maneth-b03p/analog-guitar-effects-console/report/README.md

## Project Documentation

This folder contains all the final documentation for the Analog Guitar Effect Processing Console project:

- **Datasheet** - technical specifications
- **User Manual** - instructions for operating the device
- **Final Presentation**
- **Final Report**
