maneth-b03p/analog-guitar-effects-console/report/2_CYBERTRON_EN2091_Analog_Project.pdf

Department of Electronic & Telecommunication Engineering, University of Moratuwa, Sri Lanka.

# Analog Guitar Effects Processing Console

Group Members:

230018T | D.M.G.H. Adikaram
230074J | H.Y.W. Bandara
230476T | G.M.B. Perera
230486A | U.I.H. Perera

EN 2091 Laboratory Practice and Projects

06/12/2025

Analog Guitar Effect Processing Console | Group No 2

Abstract
This project presents the Analog Guitar Effects Processing Console, a compact device integrating four analog sub-circuits for guitar tone modification: Pre-Amplifier, Equalizer, Distortion, and Tremolo. The system utilizes modular architecture for reliability. Validation was conducted via LTSpice simulation and hardware testing. Hardware validation included FFT analysis to confirm the active equalizer’s effective boost/cut ranges and oscilloscope and digital multimeter readings for the rest of the circuit. The console successfully demonstrates a functional, portable, and versatile analog audio processing unit.

1

## Abbreviations and Acronyms

FFT Fast Fourier Transform

SR Slew Rate

DC Direct Current

AC Alternating Current

PCB Printed Circuit Board

LFO Low Frequency Oscillator

AWGN Additive White Gaussian Noise

2

## Contents

Abstract | 1
1 Introduction and Functionality | 4
2 System Architecture | 4
3 Component Selection | 5
4 PCB Design | 7
5 Enclosure Design | 9
6 Software Simulation and Hardware Testing | 10
7 Conclusion & Future Works | 13
8 Contribution of Group Members | 13
Acknowledgements | 14
Appendix | 14

3

## 1 Introduction and Functionality

This project aims to introduce a compact, custom audio console intended to for use with analog input devices, primarily the electric guitar. The output is designed to be fed directly into a separate power amplifier, allowing musicians to pre-set their entire core tone and effects chain in a single, portable device.
The console is engineered for live performance reliability and portability, requiring only initial setup and minor, on-the-demand adjustments.

This console consists of four main parts:

- Pre-Amplifier: For initial gain
- Equalizer: To amplify different frequency ranges (High, Mid, Treble)
- Tremolo: For Tremolo effect. The frequency and Depth can be controlled.
- Distortion: Distortion effect can be controlled

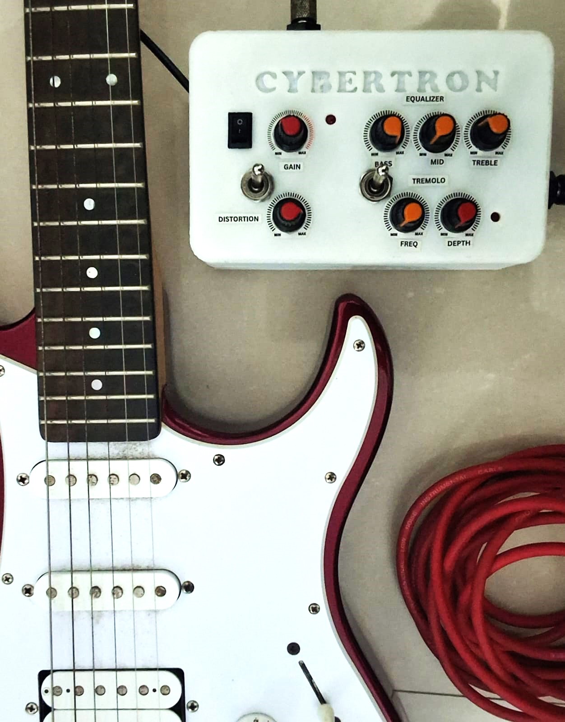
[picture p2: figure]

Figure 1: Analog Guitar Effects Unit

## 2 System Architecture

In this section, we’ll go through the circuitry system in an abstract manner. We’ll also mention the equations that help in identifying key parameters related to the product.

4

### 2.1 System-Level Abstraction of the Device

In Figure 2, we can see how the four systems are interconnected with input and output signals and how they are powered up and optionally bypassed.

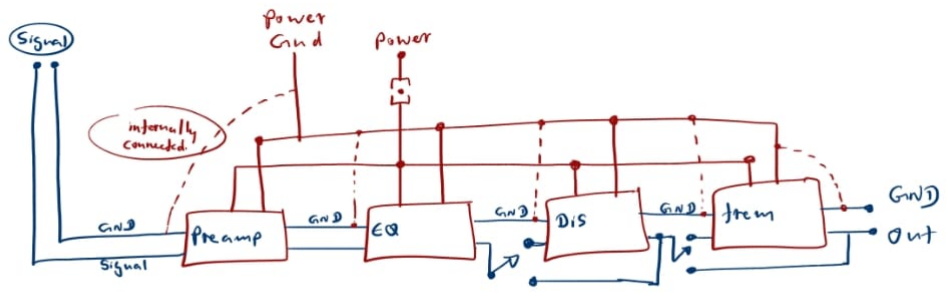
[picture p3: figure]

Figure 2: Flowgraph of the Circuitry

### 2.2 Equations

- Pre-Amplifier Voltage Gain (Av):

Av = 1 +

Rf
Ri
- Baxandall EQ Center Frequency for the mid-range control:

ωc =

1
RC
- Tremolo Timing (NE555 Astable Mode):

f =

1.44
(RA + 2RB)C

Duty Cycle(%) = RA + RB
RA + 2RB

× 100

### 2.3 Sub-Circuits

The device contains four separate sub-circuits–one for each effect– so that each module can be built, tested, and verified independently before integration. This simplifies debugging, as any failure or undesired behavior can be quickly isolated. Also, if any fault occurs during a live performance (eg: Tremolo Board), it can be quickly swapped out without having to replace or repair the entire console circuit.

## 3 Component Selection

In this section, we will illustrate some of the decisions we made in selecting components and the reasons behind them.

- TL071CP / TL082CP

Requirements:

– Power dissipation at idle: 0.4 mW – Op-amp bandwidth: 80 Hz to 3 kHz

5

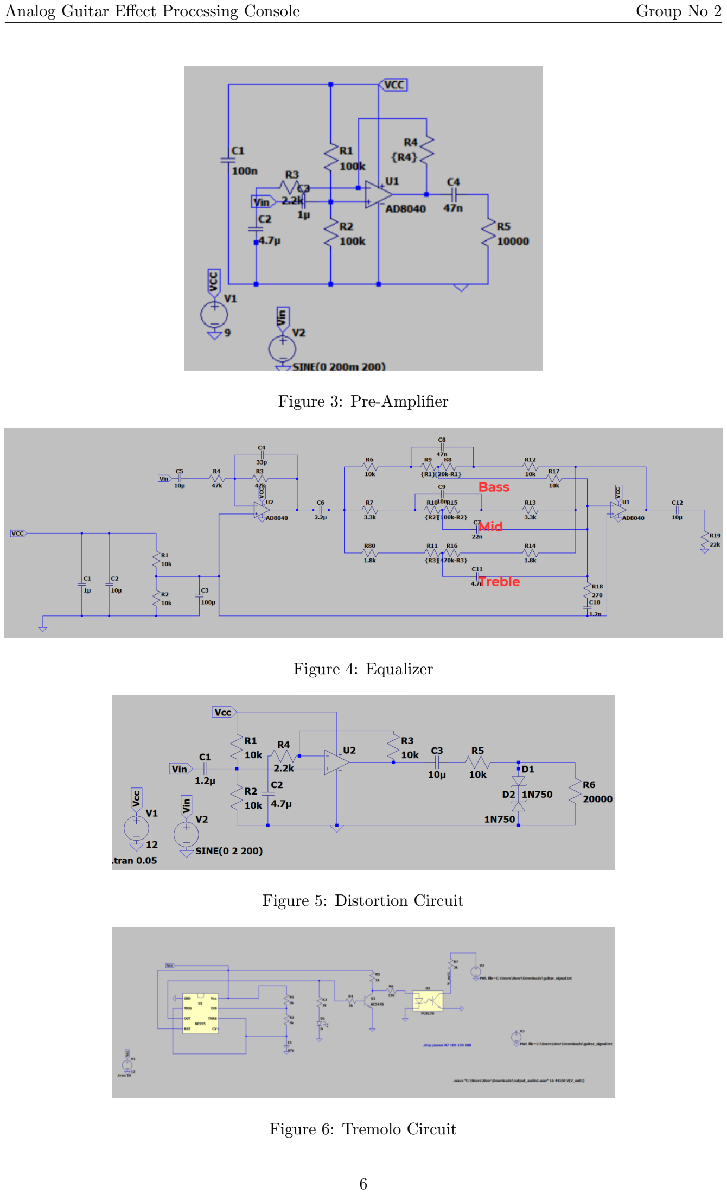
[picture p4: page 7]

Figure 3: Pre-Amplifier

Figure 4: Equalizer

Figure 5: Distortion Circuit

Figure 6: Tremolo Circuit

6

– Input amplitude:
∗ Average: 100–200 mV
∗ Maximum: 500 mV

– Expected output amplitude: 1–2 V

– Required gain-bandwidth product: 0.064 MHz
– Required slew rate (SR): 226.1 V/ms

We used popular low-noise operational amplifiers TL082CP (Dual Op-amp) and TL072CP (Single Op-amp) since they satisfy all the requirements. For the circuits that require two op-amps, such as the Equalizer, we used the dual op-amp to reduce component count.

- NE555 Timer

We used this hybrid component because of its simplicity, reliability, and stability in providing an accurate timing for tremolo effect, which is essential in live performances. For this particular application, we used Astable mode.

- Zener Diode Selection

We observed that the output of the equalizer is around 2V − 3V . To have a good distortion effect, it should be able to produce a higher gain (for consistency in volume) to be clipped. So we used 3.3V zener diodes so that the signal can be clipped around 4V , necessitating the requirement.

- Resistors and Capacitors

Based on circuit simulations and mathematical Equations provided in Section 2.2.

## 4 PCB Design

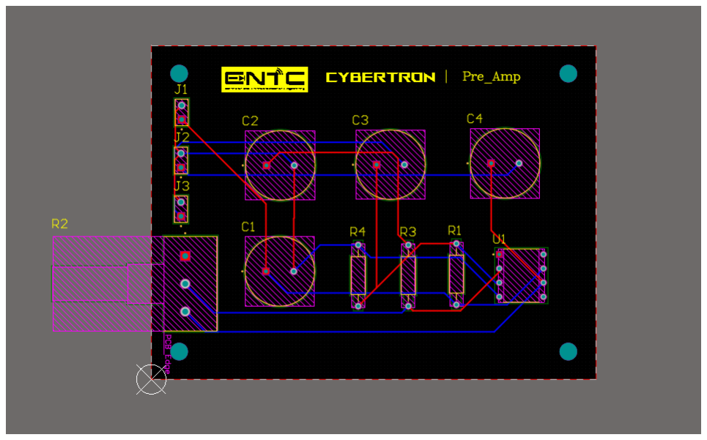
[picture p5: figure]

Figure 7: Pre-Amplifier

7

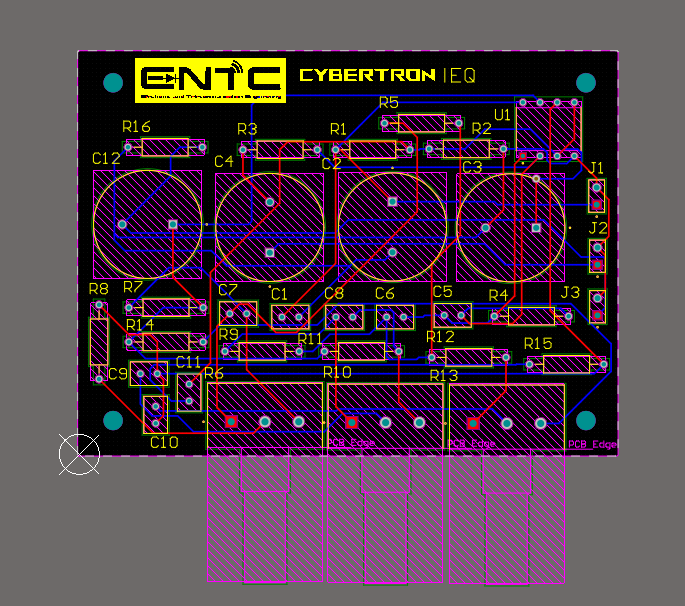
[picture p6: figure]

Figure 8: Equalizer

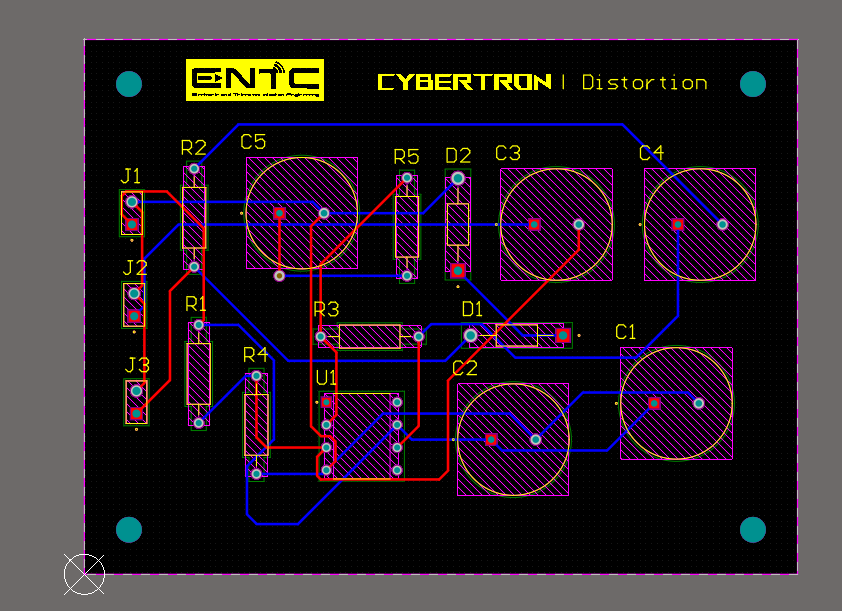
[picture p7: figure]

Figure 9: Distortion

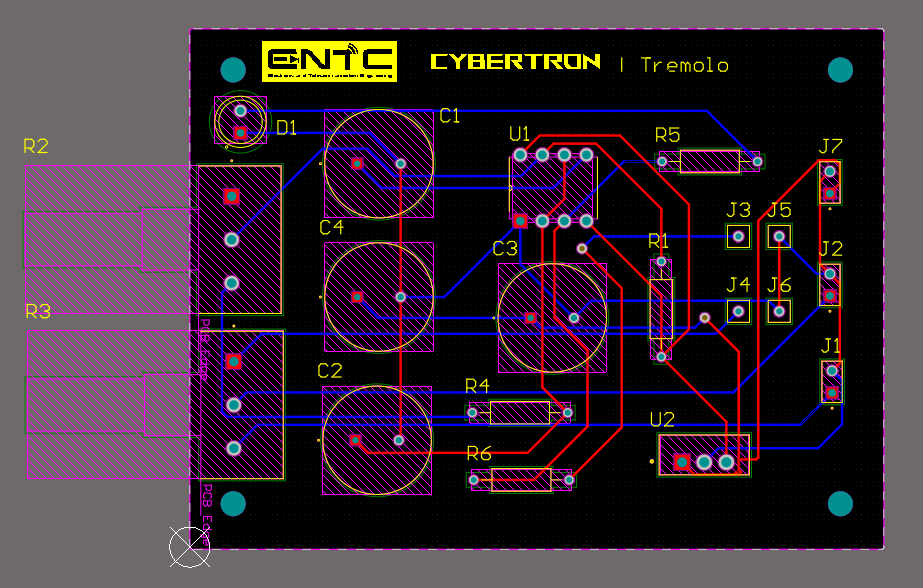
[picture p8: figure]

Figure 10: Tremolo

All the PCB designs are 80 mm × 60 mm in dimensions and consist of two layers. Designs are done using Altium Designer software.

8

## 5 Enclosure Design

Physical Specifications

- Enclosure Dimensions (L × W × H): 160 mm × 100 mm × 53 mm
- Overall Weight: 200 g
- Fabrication Material: PLA (Polylactic Acid)

SOLIDWORKS Designs

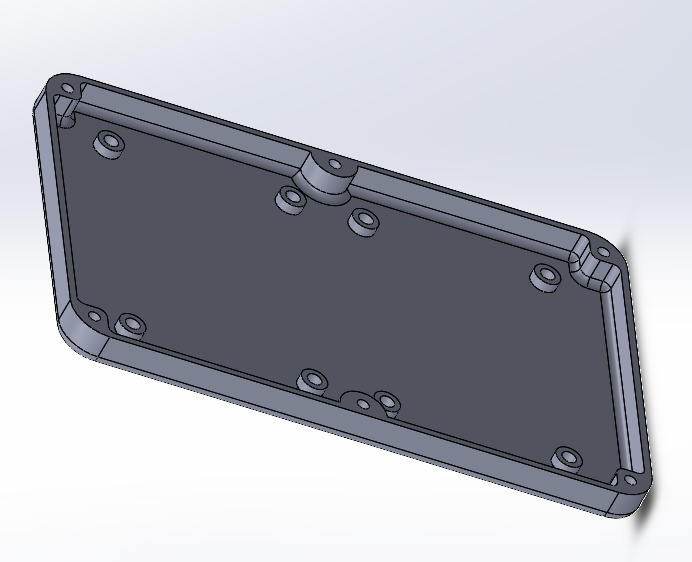
[picture p9: figure]

Figure 11: Bottom Lid

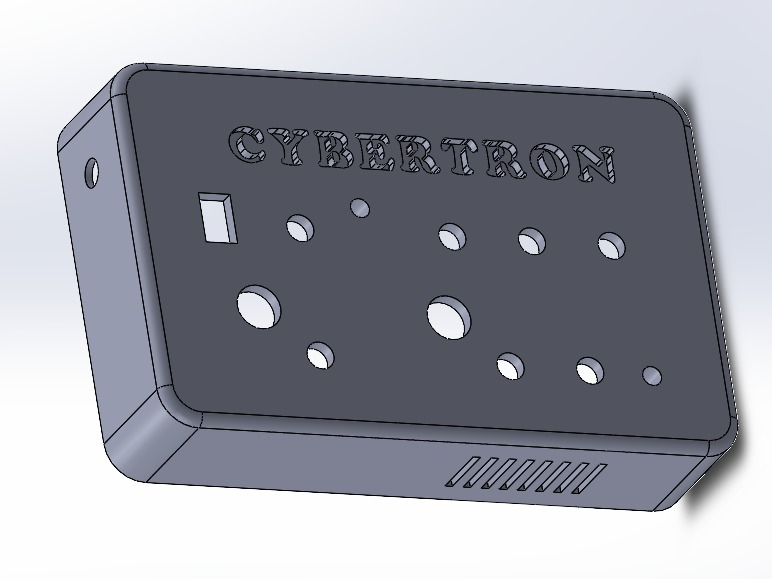
[picture p10: figure]

Figure 12: Top Lid

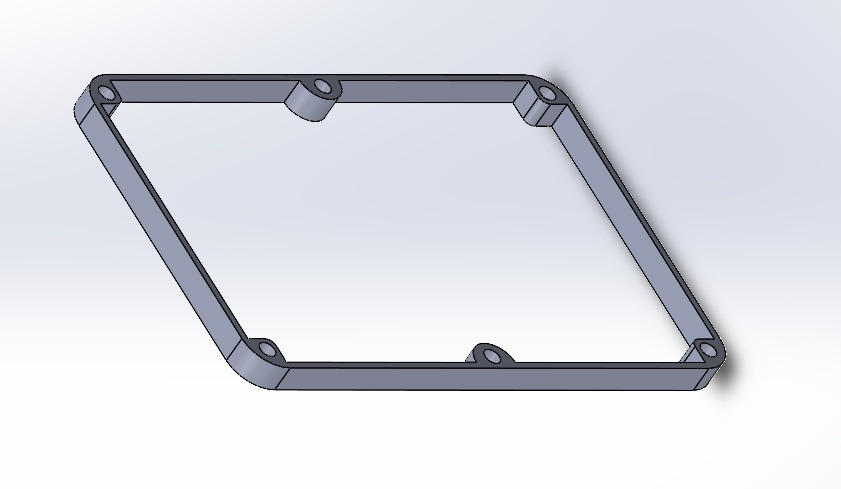
[picture p11: figure]

Figure 13: Inter-Layer

9

## 6 Software Simulation and Hardware Testing

This section details the verification of the console’s functional blocks through circuit simulation (LTSpice) and the validation of key performance metrics using hardware testing and analysis (Fast Fourier Transform, FFT).

### 6.1 Simulation Results (LTSpice)

Each module’s design was simulated to ensure expected electrical behavior, gain structure, frequency response, and transient stability before fabrication.

### 6.1.1 Pre-Amplifier Simulation

- Goal: Verify whether the required gain is achieved with minimal phase offset.
- Result: The simulation confirmed a maximum non-inverting gain of 20 dB with negligible DC offset, correctly driving the signal to the Equalizer stage.

Figure 14:

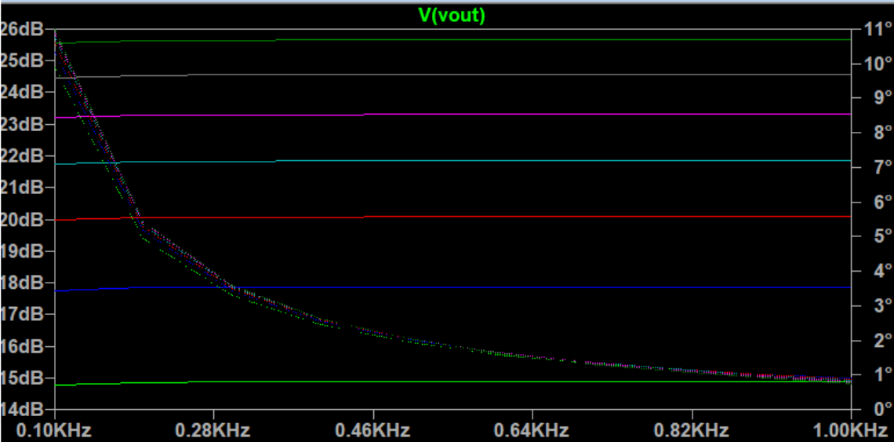
[picture p12: figure]

1) — Gain Stability of pre-amp across a range of frequencies, for different values of potentiometer (0 Ω - 20 Ω )
2) - - Phase offset for different potentiometer values. Observation: Negligible phase offsets.

### 6.1.2 Equalizer Simulation

- Goal: Verify the center frequencies and the maximum boost/cut range of the three-band active filter.
- Result: Output voltage for 2V input from preamp shows that the required gain and cutoff frequencies have been achieved.

10

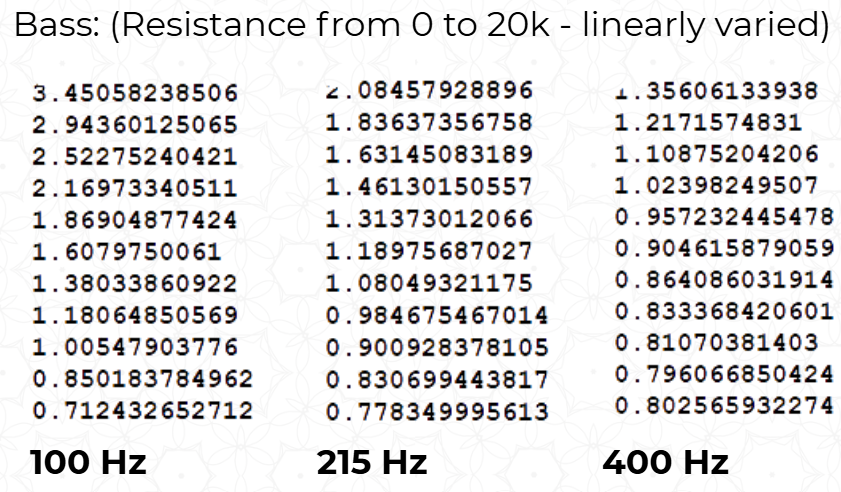
[picture p13: figure]

Figure 15: Gain variation for Bass across low frequencies

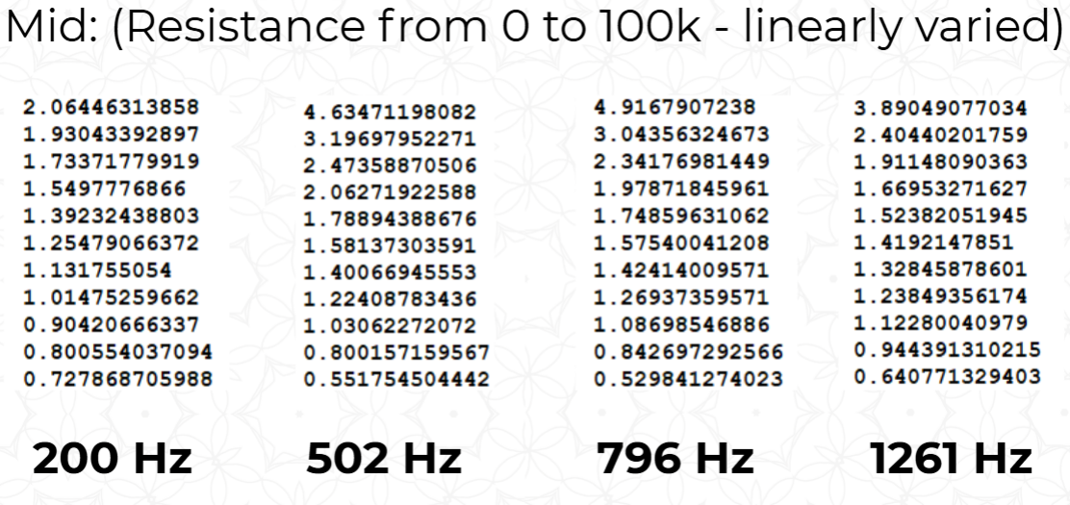
[picture p14: figure]

Figure 16: Gain variation for Mid across midband frequencies

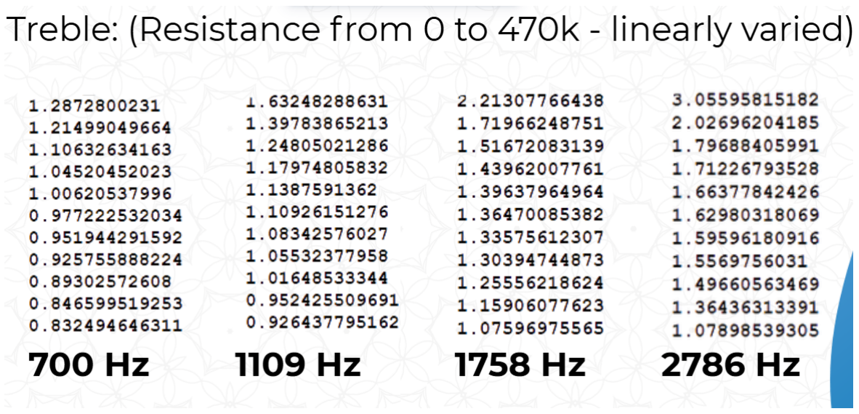
[picture p15: figure]

Figure 17: Gain variation for treble across high frequencies

### 6.1.3 Distortion Simulation

- Goal: Verify the clipping action of the back-to-back diode arrangement and distortion effect.
- Result: The transient analysis confirmed symmetrical clipping at approximately ±4 V (Zener breakdown voltage + forward bias voltage).

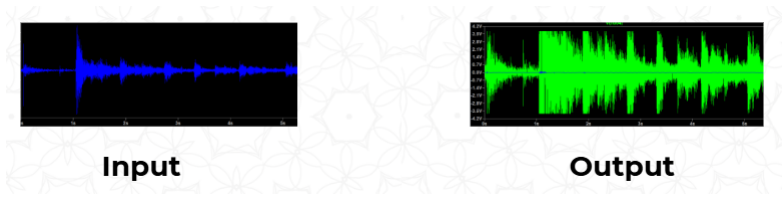
[picture p16: figure]

Figure 18: Distortion Effect: Voltage variation with respect to time

11

### 6.1.4 Tremolo Simulation

- Goal: Verify the Low Frequency Oscillator (LFO) frequency range and the modulation depth control.
- Result: The NE555 LFO circuit achieved a frequency range from 0.5 Hz to 6.5 Hz. The VCA/Opto-coupler simulation confirmed the ability to modulate the audio signal amplitude from 0% to 90% depth.

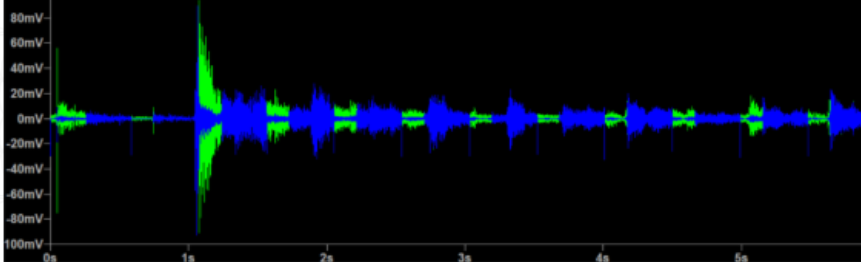
[picture p17: figure]

Figure 19: Tremolo Effect Simulation: Green - Input Signal, Blue - Output Signal

### 6.2 Hardware Testing and Validation

The physical prototype was subjected to key measurements to validate the core audio performance against specifications.

### 6.2.1 FFT Analysis for Equalizer Performance

- Test: To have a thorough understanding of frequency response, ideally, one should produce an impulse response, which isn’t practical. So what the test does is provide an AWGN signal and a normal guitar strum separately and observe the FFT through an oscilloscope.
- Goal: Confirm the filter’s response for the given frequency ranges.
- Result:

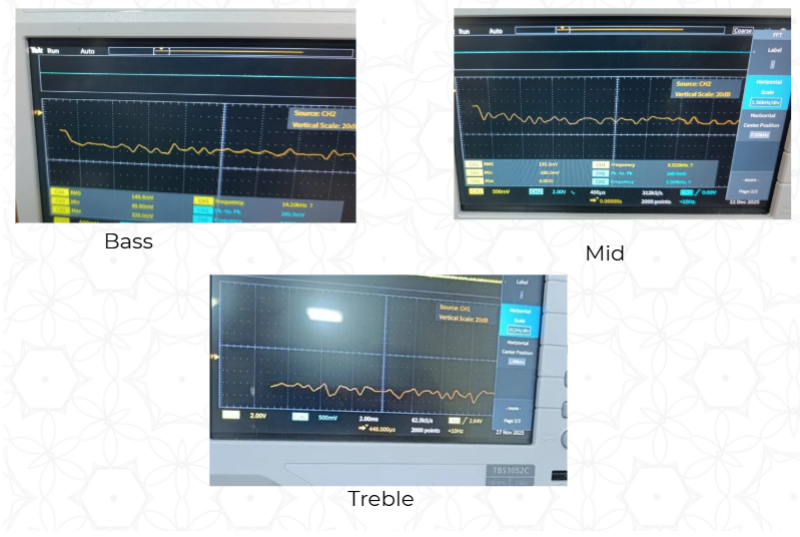
[picture p18: figure]

Figure 20: FFT plot validating the boost of magnitude and filtering of different frequency bands.

12

Explanation: Guitars naturally produce high power for low frequencies (due to higher vibrations). In addition, in the oscilloscope, it isn’t easy to distinguish base frequencies and mid frequencies due to the minimum sensitivity being 1.5 kHz/div. But the treble effect demonstrates a significant observation by attenuating lower frequencies, effectively highlighting the high frequencies of the audio.

## 7 Conclusion & Future Works

The Analog Guitar Effects Processing Console was successfully designed and validated, realizing a compact device that integrates four essential analog effects: Pre-Amplifier, Equalizer, Distortion, and Tremolo. The system’s modular, low-noise architecture was confirmed through simulation and hardware testing to meet all performance specifications, delivering a versatile and reliable multi-effect processing unit.
Future enhancements should focus on expanding the console’s versatility. The modular design allows for the straightforward integration of new effects, notably the addition of a Wah Filter and a Vibrato Effect module.

## 8 Contribution of Group Members

Table 1: Individual Group Member Contributions
Member Name / Index | Contributions
230018T D.M.G.H. Adikaram | PCB Design, Component Selection, Assembling, Soldering
230074J H.Y.W. Bandara | Circuit Testing, PCB Design, Soldering, Assembling
230476T G.M.B. Perera | Simulation Testing, Enclosure Design, Circuit Selection, Re-
| port Documentation
230486A U.I.H. Perera | Simulation Testing, Circuit Testing, Datasheet and User
| Manual Documentation

13

## Acknowledgements

The successful completion of this project was made possible by the support of the following individuals and institutions.

Our deepest gratitude is extended to Dr. Sampath Perera (Lecturer/Supervisor) for essential guidance, insightful feedback.

Thanks are also due to Mr. Avishka Edirisinghe (Group Mentor) for dedicated support and guidance during project organization and execution.

The technical staff at the Digital Laboratory of Electronic and Telecommunication Department provided necessary access to equipment and components for circuit simulation and analysis

Finally, thanks to our friends, family, and colleagues for their encouragement and support throughout this project.

## References

[1] Circuit Digest. | Audio Equalizer / Tone Control Circuit with Bass, Treble and
Mid | Frequency | Control. | https://circuitdigest.com/electronic-circuits/
audio-equalizer-tone-control-circuit-with-bass-treble-and-mid-frequency-control, .
[2] Curious Motor. Simple 555 based Tremolo Effect. https://curiousmotor.com/2020/06/04/simple-555-based-tremolo-effect/, 2020. .

## Appendix

A. Component Bill of Materials (BOM) and Estimated Cost

A list of specific components required to construct the final product, with the prices in LKR.
Component | Count | Value/Type | Unit Price | Total
IC1 | 1 | 555 Timer (NE555) | 30 | 30
IC2 | 2 | TL071CP | 50 | 100
IC3 | 1 | TL082CP | 20 | 20
Resistor | 30 | 10kΩ, 100kΩ, 22kΩ, etc. | 5 | 150
Capacitor | 20 | 1µF, 10µF, etc. | 20 | 400
Potentiometer | 7 | 100kΩ | 40 | 280
LED | 3 | Standard Red LED | 10 | 30
LDR | 1 | 4mm LDR (30kΩ − 3MΩ | 20 | 20
PCB | 4 | - | 200 | 800
AC-DC converter | 1 | 230V AC to 12V DC Transformer | 850 | 850
Enclosure | - | Manufactured using PLA | - | 2000
Additional Expenses
(Wires, Shipping,
Ports, knobs etc.) | - | - | - | 6000
Estimated Total Manufacturing Cost (LKR): | 10680
B. Mathematical Derivation of LFO Frequency

The frequency of oscillation (f) for the 555 Timer in its astable configuration, commonly used for the Tremolo LFO, is determined by the timing resistors (RA, RB) and the timing capacitor (C).

| | 14

The frequency is calculated using the following equation:

f =

1.44
(Ra + 2Rb)C

Ra = 50 kΩ

Rb = 0–500 kΩ (variable resistor)

C = 47 µF

fmin = 0.549 Hz

fmax = 6.417 Hz

In a practical tremolo circuit, one of the resistors (typically RB) is made variable (a potentiometer) to allow the user to adjust the modulation rate. For slow modulation, CT must be large (e.g., 1µF or larger).

15
