maneth-b03p/analog-guitar-effects-console/report/Presentation.pdf

# ANALOG GUITAR

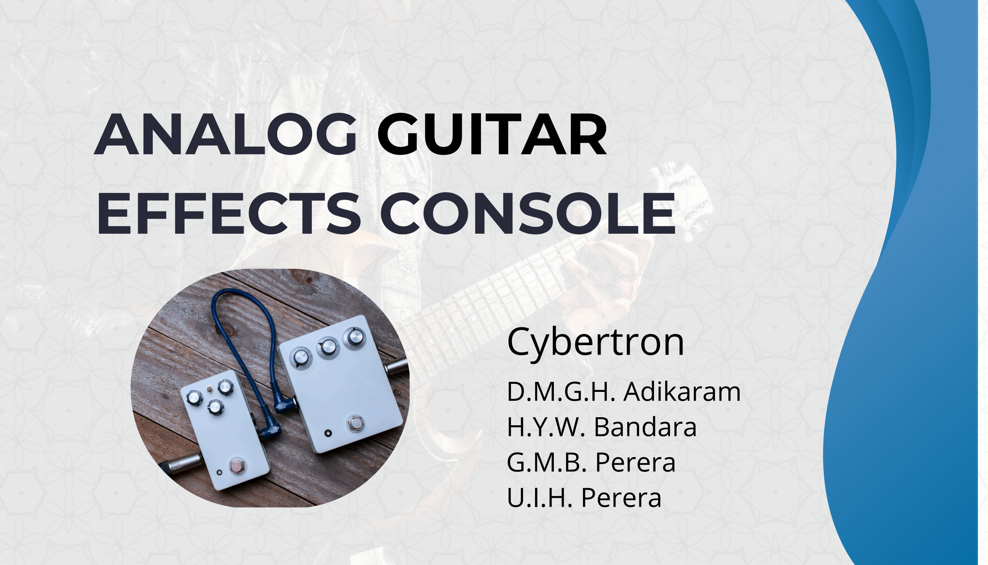
[picture p19: page 1]

# EFFECTS CONSOLE

### Cybertron D.M.G.H. Adikaram

### H.Y.W. Bandara G.M.B. Perera U.I.H. Perera

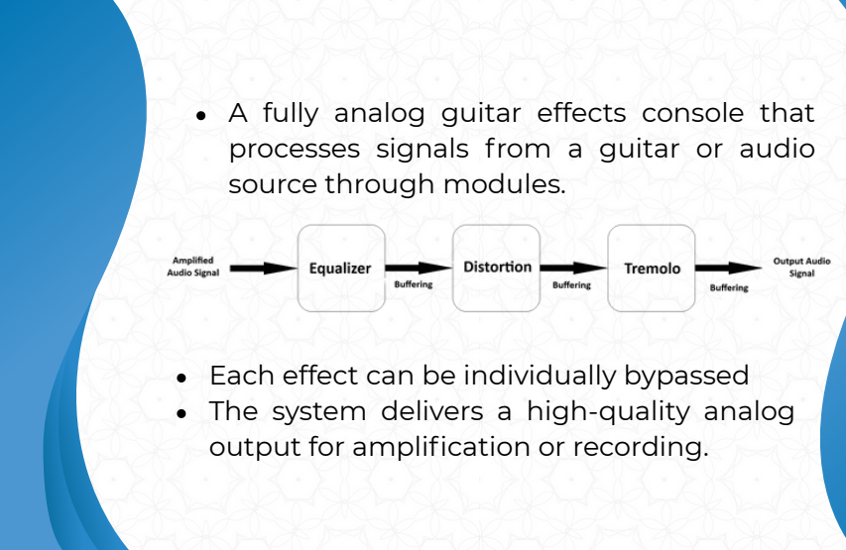
[picture p20: figure]
source through modules.; output for amplification or recording.

A fully analog guitar effects console that processes signals from a guitar or audio

Each effect can be individually bypassed The system delivers a high-quality analog

# Outcome of each sub-circuit

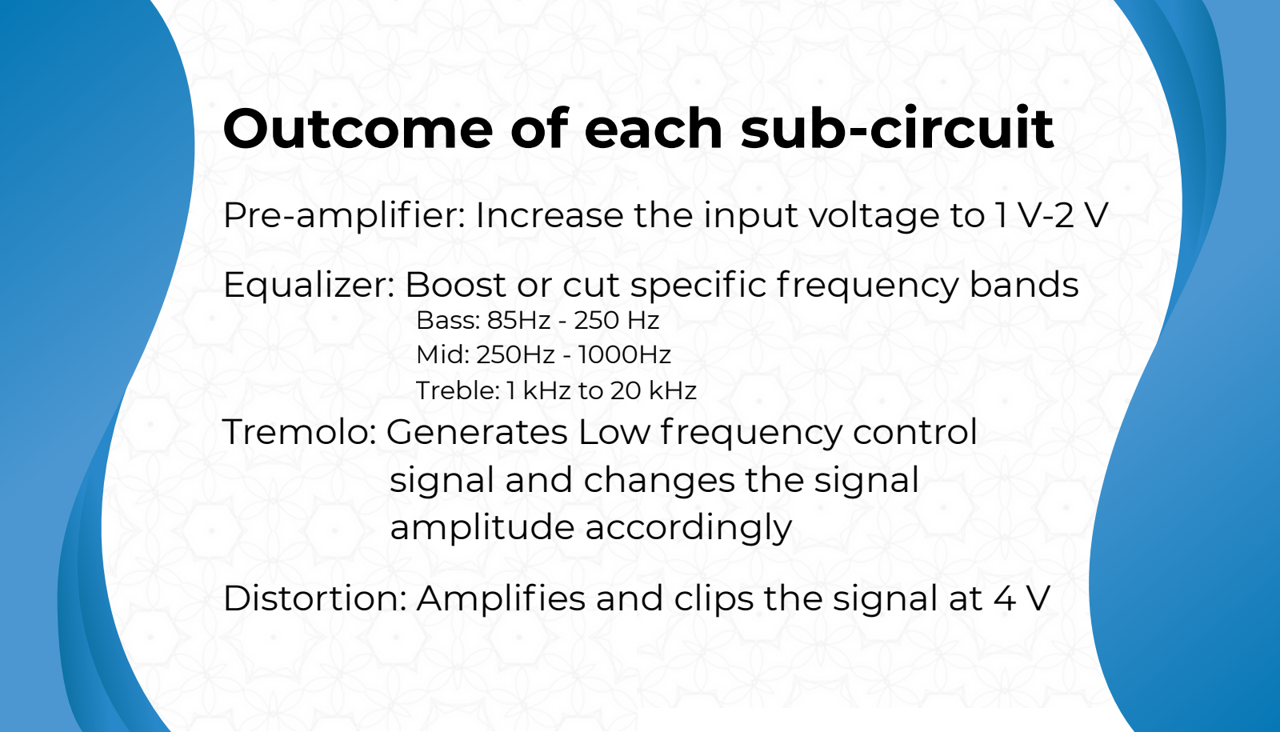
[picture p21: page 3]

Pre-amplifier: Increase the input voltage to 1 V-2 V Equalizer: Boost or cut specific frequency bands Bass: 85Hz - 250 Hz Mid: 250Hz - 1000Hz

Treble: 1 kHz to 20 kHz
Tremolo: Generates Low frequency control signal and changes the signal amplitude accordingly
Distortion: Amplifies and clips the signal at 4 V

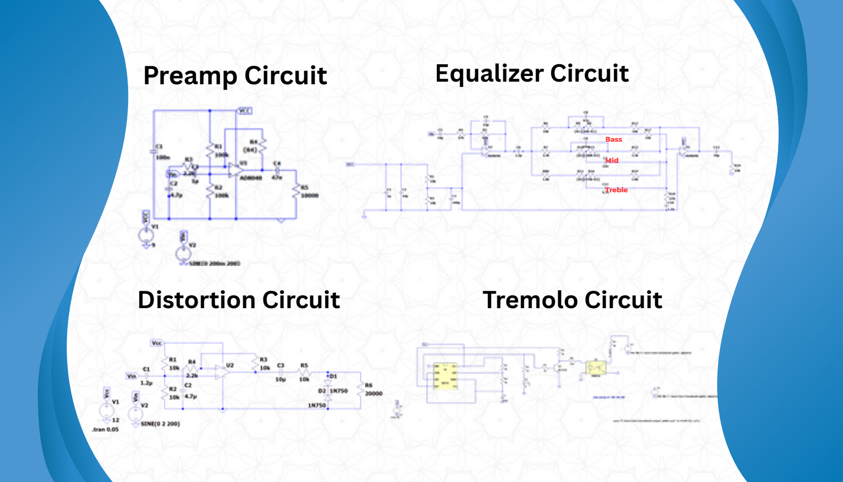
[picture p22: page 4]

Preamp Circuit | Equalizer Circuit

Bass Mid

Treble

Distortion Circuit | Tremolo Circuit

# Equalizer Circuit

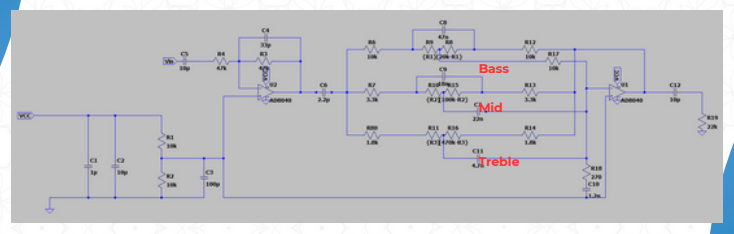
[picture p23: figure]
Bass; Mid; Treble

# Equalizer Circuit

Bass: (Resistance from 0 to 20k - linearly varied)

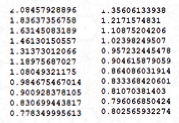
[picture p24: figure]
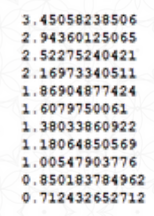
[picture p25: figure]

100 Hz | 215 Hz | 400 Hz

# Equalizer Circuit

Mid: (Resistance from 0 to 100k - linearly varied)

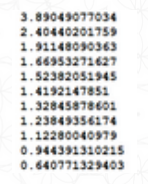
[picture p26: figure]
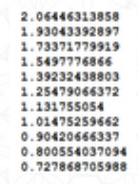
[picture p27: figure]

200 Hz | 502 Hz | 796 Hz | 1261 Hz

# Equalizer Circuit

Treble: (Resistance from 0 to 470k - linearly varied)

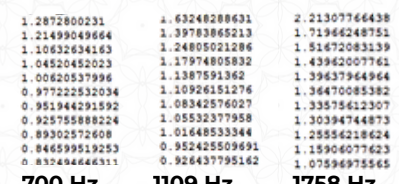
[picture p28: figure]
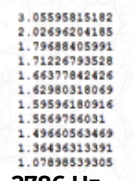
[picture p29: figure]

700 Hz | 1109 Hz | 1758 Hz | 2786 Hz

# Equalizer Circuit

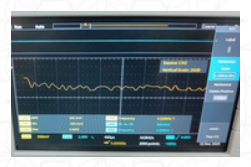
[picture p30: figure]
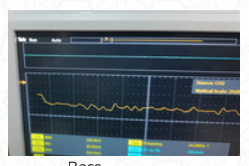
[picture p31: figure]

Bass | Mid

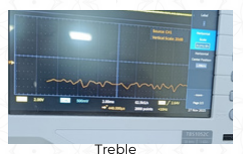
[picture p32: figure]

Treble

# Distortion Circuit

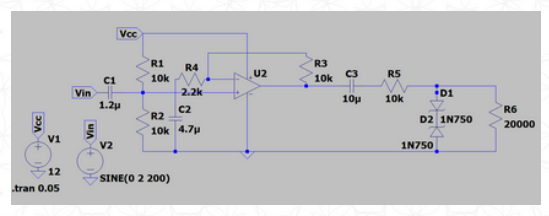
[picture p33: figure]

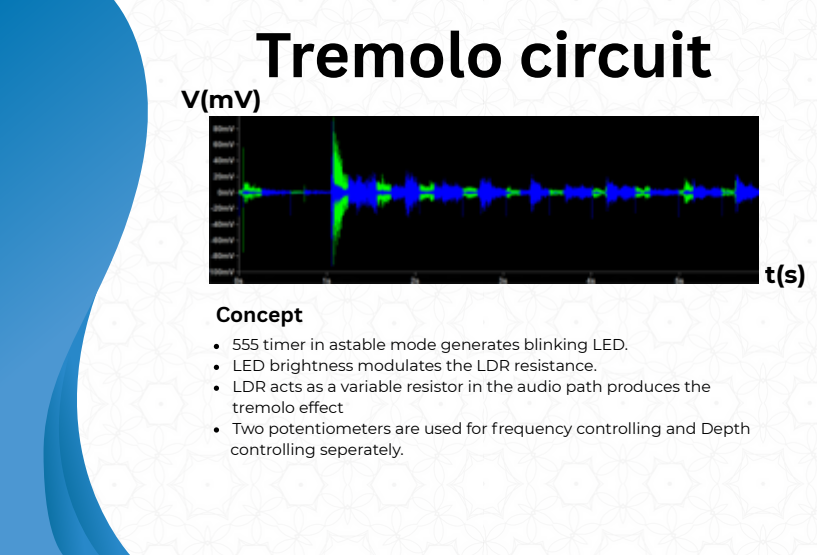
[picture p34: figure]
Tremolo circuit; tremolo effect; controlling seperately.

Concept 555 timer in astable mode generates blinking LED.

LED brightness modulates the LDR resistance.
LDR acts as a variable resistor in the audio path produces the

Two potentiometers are used for frequency controlling and Depth

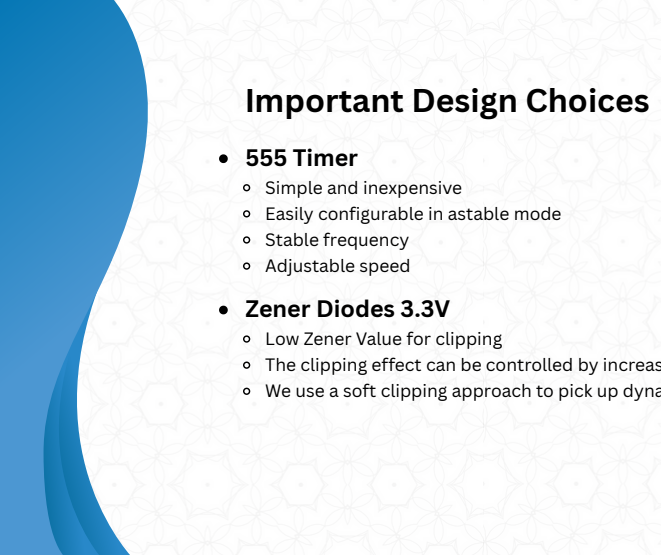
[picture p35: figure]
555 Timer; Simple and inexpensive Easily configurable in astable mode Stable frequency Adjustable speed; Important Design Choices; Zener Diodes 3.3V; Low Zener Value for clipping

The clipping effect can be controlled by increasing the gain. We use a soft clipping approach to pick up dynamics.

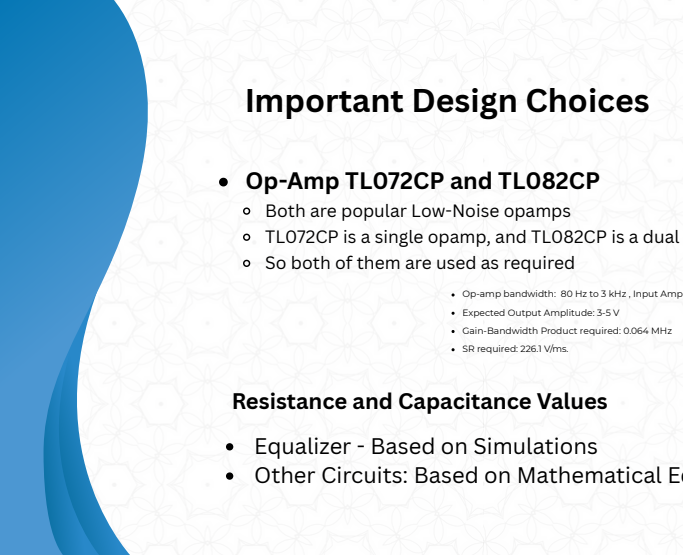
[picture p36: figure]
Important Design Choices; Op-Amp TL072CP and TL082CP; Both are popular Low-Noise opamps; So both of them are used as required; Expected Output Amplitude: 3-5 V; Gain-Bandwidth Product required: 0.064 MHz; SR required: 226.1 V/ms.

TL072CP is a single opamp, and TL082CP is a dual opamp

Resistance and Capacitance Values Equalizer - Based on Simulations

Other Circuits: Based on Mathematical Equations

Op-amp bandwidth: 80 Hz to 3 kHz , Input Amplitude: max 1.5 V

PCB Design (Done Using Altium Designer)

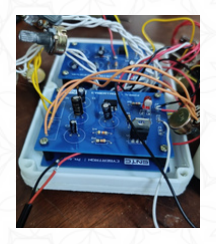
[picture p37: figure]

Enclosure Design (Done Using SolidWorks)

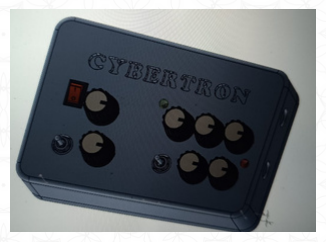
[picture p38: figure]

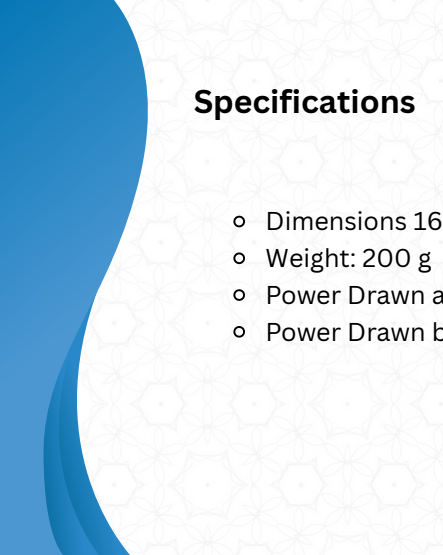
[picture p39: figure]
Weight: 200 g

Specifications Dimensions 160 mm X 100 mm X 53 mm

Power Drawn at idle stage : 150mW Power Drawn by Power Amplifier: 5 mW

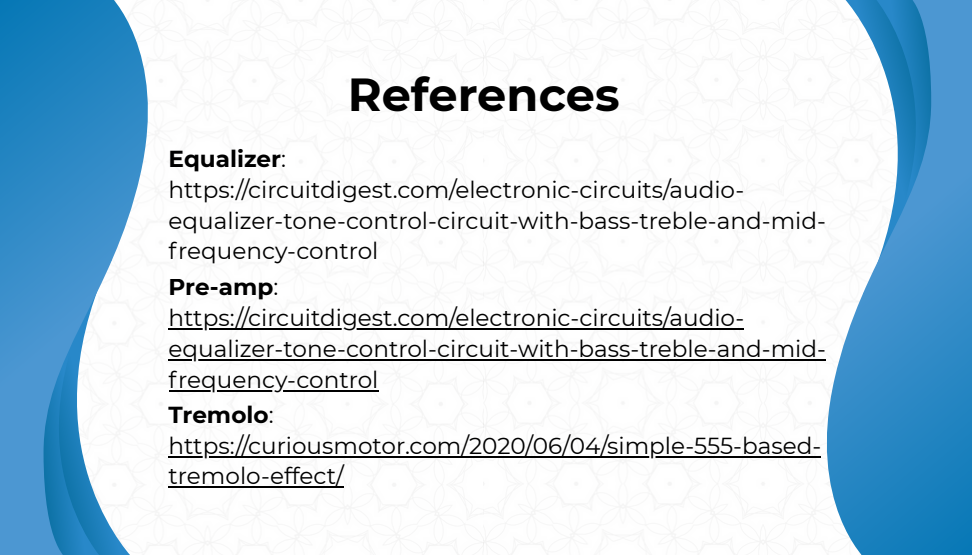
[picture p40: figure]
References; Equalizer: https://circuitdigest.com/electronic-circuits/audio- equalizer-tone-control-circuit-with-bass-treble-and-mid- frequency-control Pre-amp: https://circuitdigest.com/electronic-circuits/audio- equalizer-tone-control-circuit-with-bass-treble-and-mid- frequency-control Tremolo: https://curiousmotor.com/2020/06/04/simple-555-based- tremolo-effect/

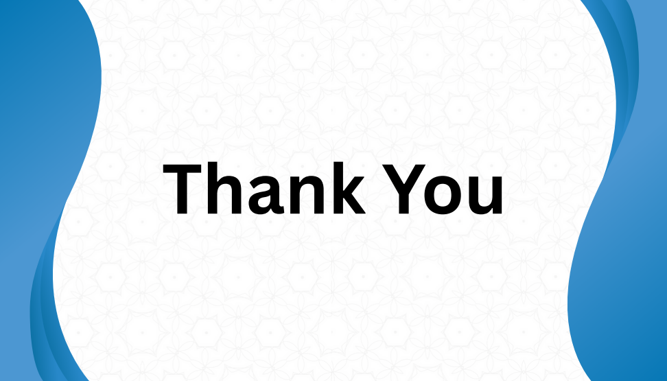
[picture p41: figure]
Thank You
