maneth-b03p/analog-guitar-effects-console/report/User Manual.pdf

# USER

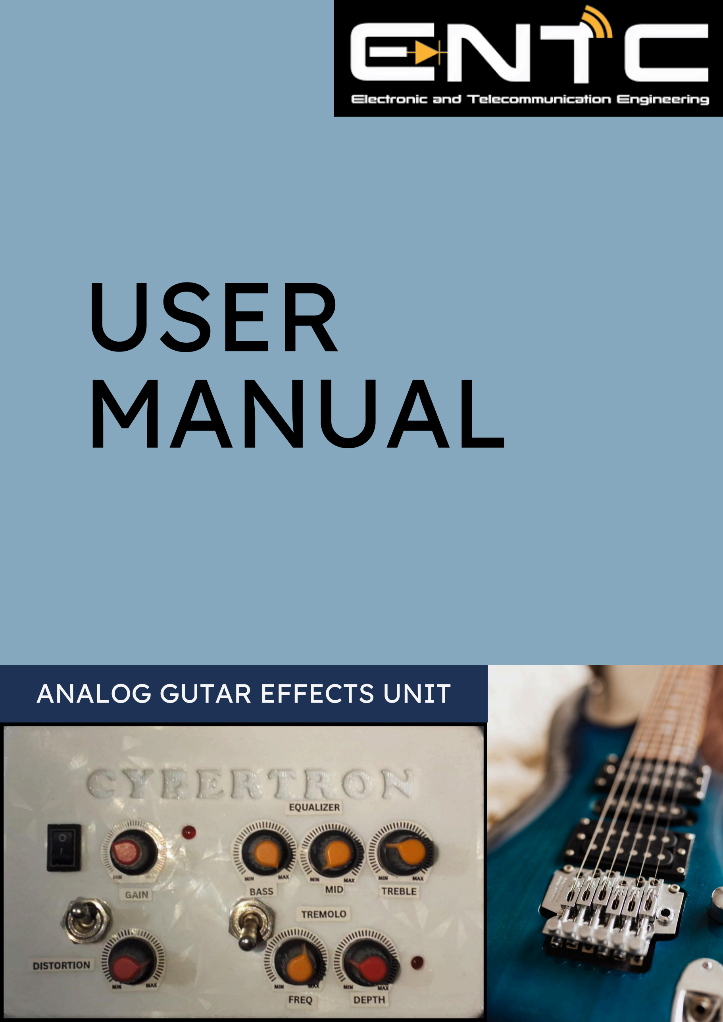
[picture p42: page 1]

# MANUAL

## ANALOG GUTAR EFFECTS UNIT

# TABLE OF CONTENT

CYBERTRON

## 1.Introduction

## 2.Safety & Usage notes

## 3.Quick Start

## 4.Effects

## a.Preamplifier

## b.Equalizer

## c.Distortion

## d.Tremolo

## 5.Technical Specifications

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
# INTRODUCTION

### Cybertrone Analog Guitar Effect Unit is made to add high-quality plugins for your guitar. It has 3 independent 100% analog effects that can be added separately with an inbuilt controllable

preamplifier.

## 3-Band Equalizer (treble, mid, bass) Distortion Tremolo

# SAFETY AND USER NOTES

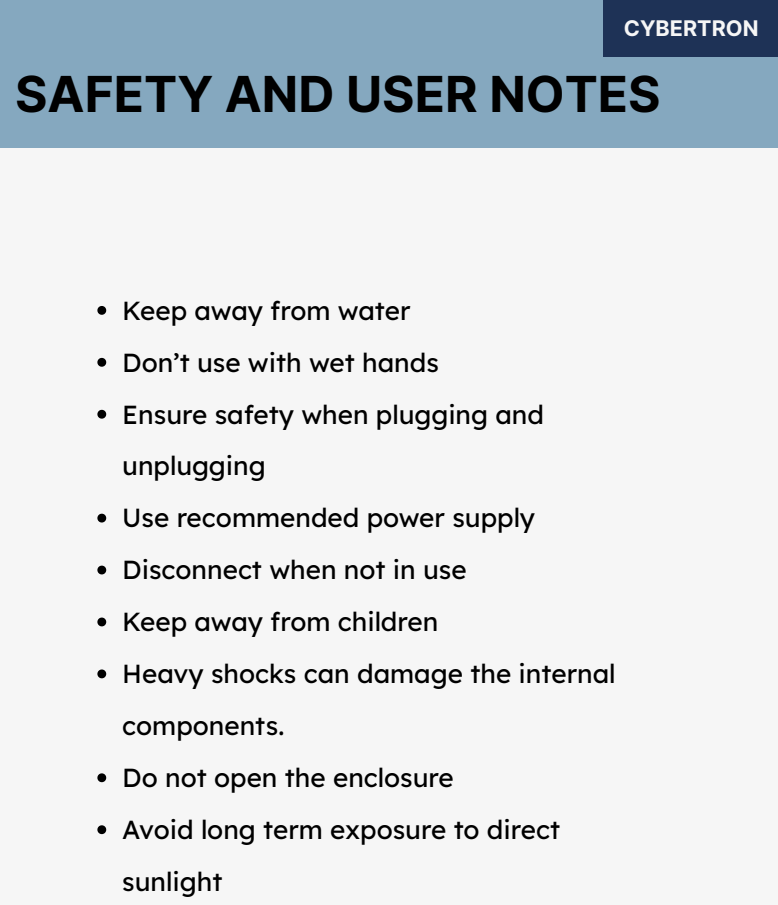
[picture p43: page 4]

Keep away from water
Don’t use with wet hands
Ensure safety when plugging and
unplugging
Use recommended power supply
Disconnect when not in use
Keep away from children
Heavy shocks can damage the internal
components.
Do not open the enclosure
Avoid long term exposure to direct
sunlight

Connect the guitar to the input Connect the output to the speakers. Switch on the unit
Set all nobs to 12'00 o clock
Play, enable and adjust each effect as necessary

# QUICK START

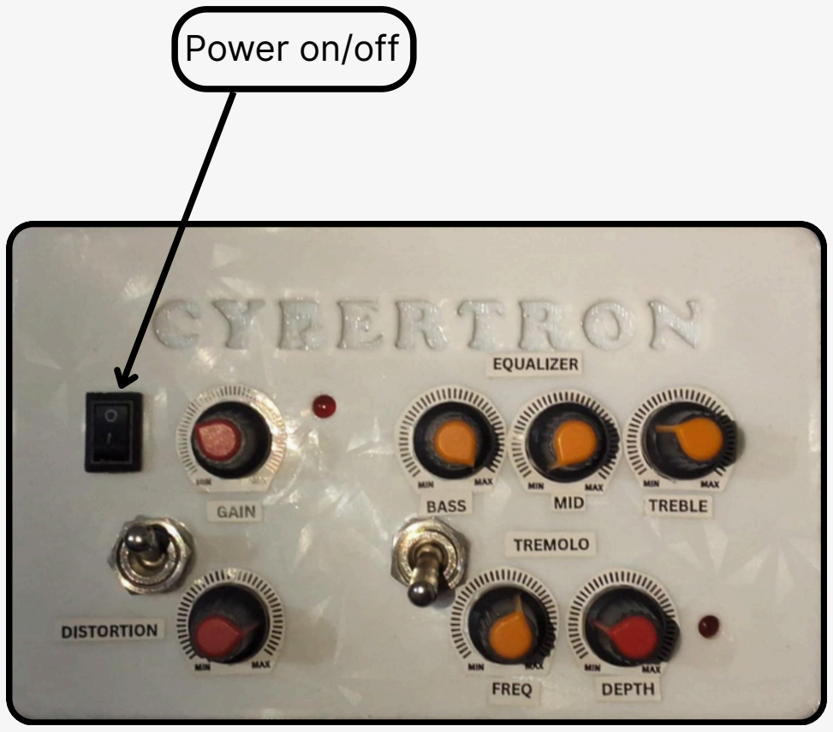
[picture p44: figure]
Power on/off

Boost and stabilize the guitar audio signal before applying further effects.

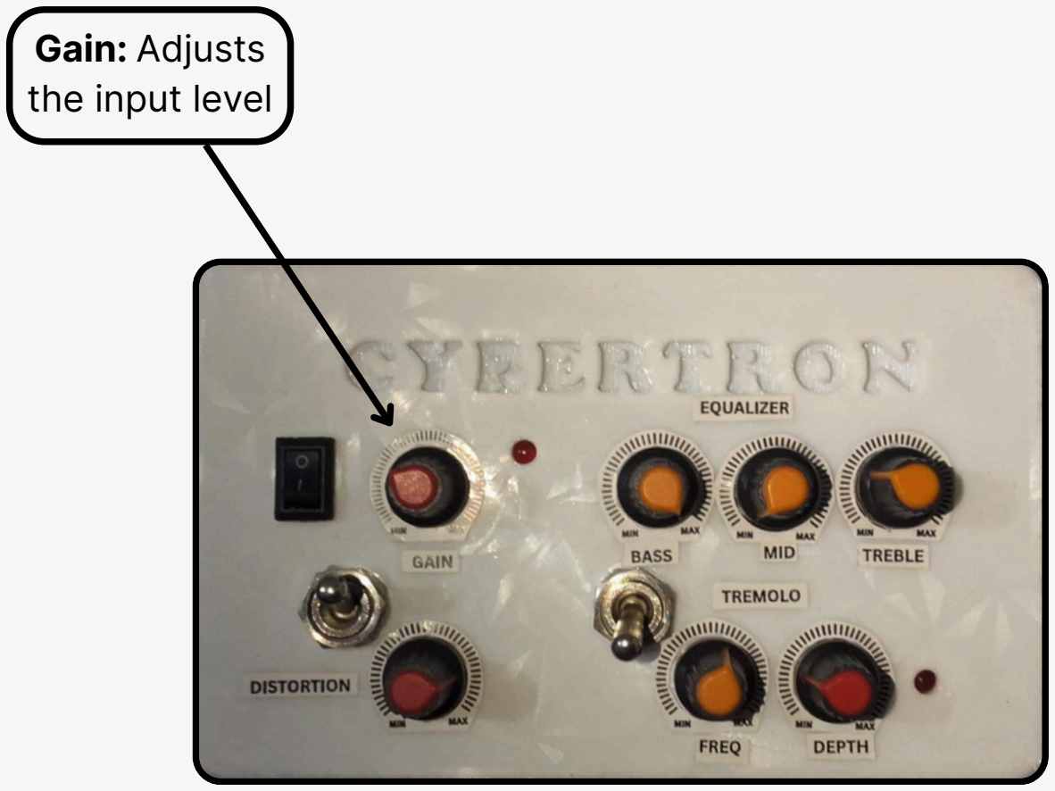
[picture p45: figure]
Gain: Adjusts the input level

Higher gamin can clip or distort the audio

# EFFECTS

## Preamplefier

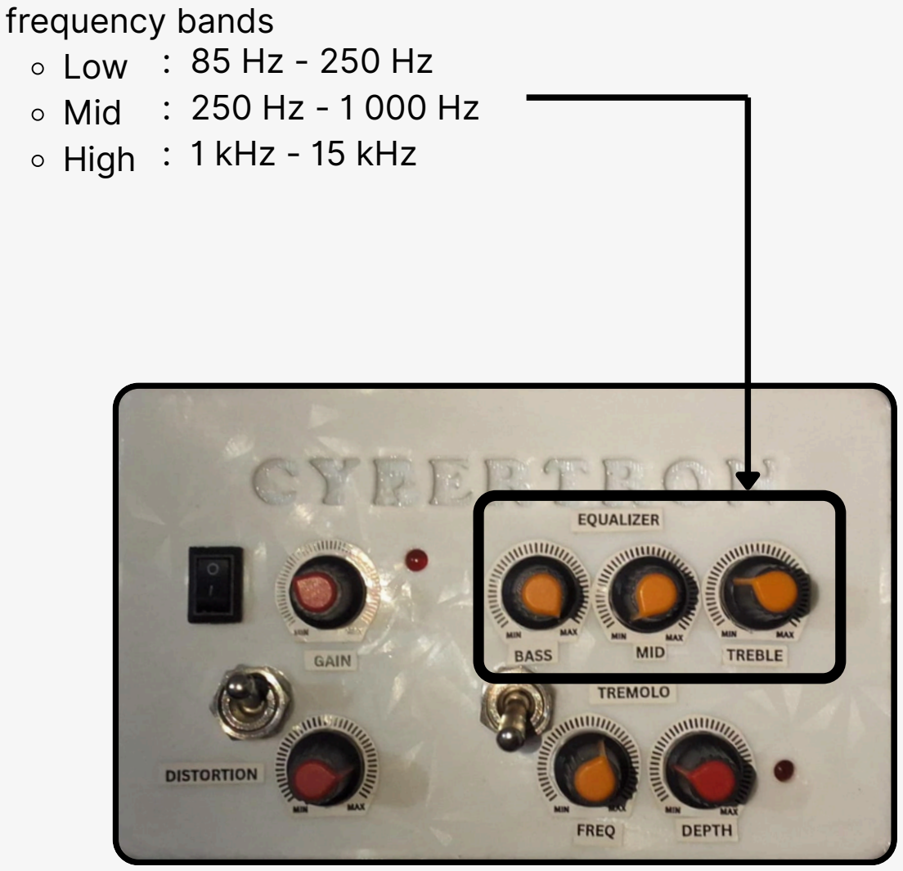
[picture p46: figure]
frequency bands Low Mid High; : 85 Hz - 250 Hz : 250 Hz - 1 000 Hz : 1 kHz - 15 kHz

Higher gamin can clip or distort the audio

Equalizer can be used to shape the tone in three

# EFFECTS

## Equalizer

Make the tone heavier by intentionally clipping the Audio

# EFFECTS

## Distortion

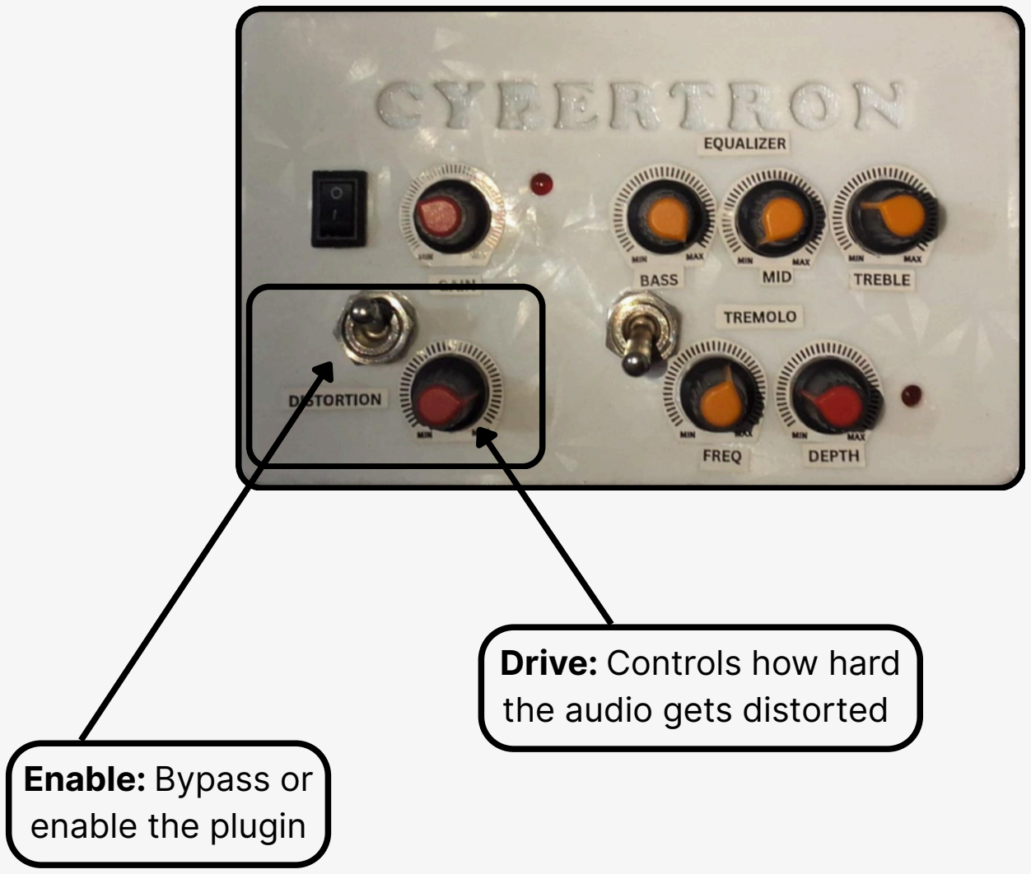
[picture p47: figure]
Enable: Bypass or enable the plugin; Drive: Controls how hard the audio gets distorted

Periodically modulate the audio signal

# EFFECTS

## Tremolo

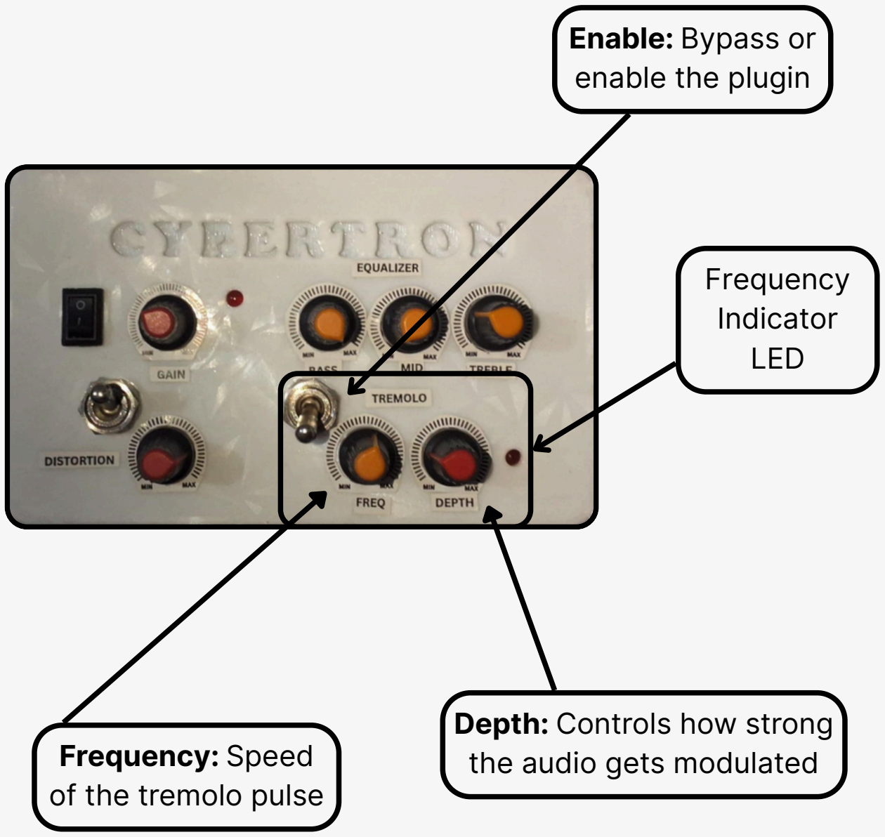
[picture p48: figure]
Enable: Bypass or enable the plugin; Depth: Controls how strong; Frequency: Speed; the audio gets modulated; of the tremolo pulse; Frequency Indicator LED

### Supply voltage: 12 V

# TECHNICAL SPECIFICATIONS

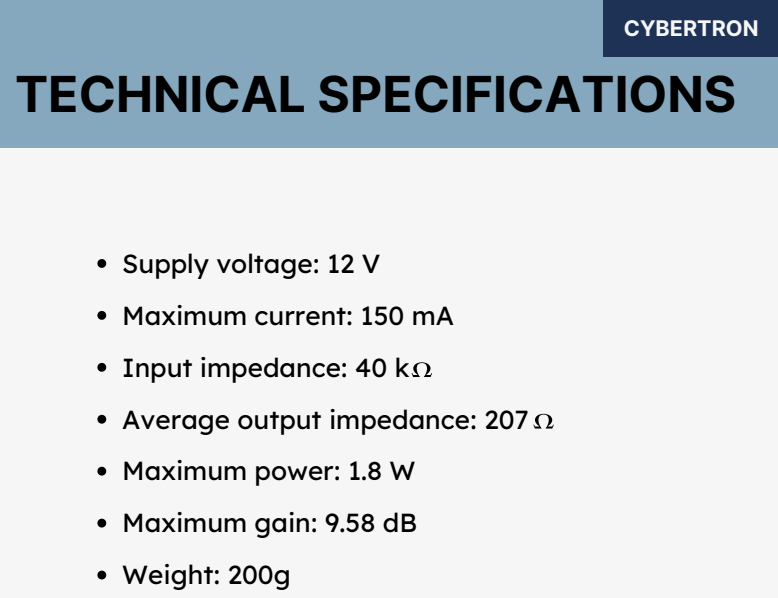
[picture p49: page 10]

Maximum current: 150 mA
Input impedance: 40 k
Average output impedance: 207
Maximum power: 1.8 W
Maximum gain: 9.58 dB
Weight: 200g
