maneth-b03p/analog-guitar-effects-console/simulation-files/Distortion.asc

C1: cap; 1.2µ
C2: cap; 4.7µ
C3: cap; 10µ
D1: zener; 1N750
D2: zener; 1N750
R1: res; 10k
R2: res; 10k
R3: res; 10k
R4: res; 2.2k
R5: res; 10k
R6: res; 20000
U2: UniversalOpAmp2
V1: voltage; 12
V2: voltage; SINE(0 2 200)
Named nets: 0, Vcc, Vin
.tran 0.05
