maneth-b03p/analog-guitar-effects-console/simulation-files/equalizer.asc

C1: cap; 1µ
C2: cap; 10µ
C3: cap; 100µ
C4: cap; 33p
C5: cap; 10µ
C6: cap; 2.2µ
C7: cap; 22n
C8: cap; 47n
C9: cap; 18n
C10: cap; 1.2n
C11: cap; 4.7n
C12: cap; 10µ
R1: res; 10k
R2: res; 10k
R3: res; 47k
R4: res; 47k
R6: res; 10k
R7: res; 3.3k
R8: res; {20k-R1}
R9: res; {R1}
R10: res; {R2}
R11: res; {R3}
R12: res; 10k
R13: res; 3.3k
R14: res; 1.8k
R15: res; {100k-R2}
R16: res; {470k-R3}
R17: res; 10k
R18: res; 270
R19: res; 22k
R80: res; 1.8k
U1: UniversalOpAmp5
U3: UniversalOpAmp5
V1: voltage; 12
V2: voltage; SINE(0 2 {f})
Named nets: 0, VCC, Vin
.tran 1m
.step param R1 0.1k 19.9k 2k
.step param R2 0.1k 99.9k 10k
.step param R3 500 469k 50k
.step dec param f 700 5000 5
.meas TRAN Vpeak_peak PP V(N012)
.param R1=19k
.param R2=90k
.param R3=460k
.meas TRAN Av_ratio PARAM Vpeak_peak/2
For variable input frequencies
Potentiometer values
Set fix values to one or more potentiometers for analysis(optional)
