maneth-b03p/analog-guitar-effects-console/simulation-files/preamp1.asc

C1: cap; 100n
C2: cap; 4.7µ
C3: cap; 1µ
C4: cap; 10µ
R1: res; 100k
R2: res; 100k
R3: res; 2.2k
R4: res; {R4}
R5: res; 10000
U2: UniversalOpAmp; Avol=1Meg GBW=3Meg Vos=3; En=18 Enk=0 In=0 Ink=0 Rin=500Meg
V1: voltage; 9
V2: voltage; SINE(0 400m 500); AC 1
Named nets: 0, VCC, Vin, Vout
.tran 0.05
.meas voutpkpk PP V(n004)
.wave "C:\\Users\\User\\Downloads\\output_audio.wav" 16 44100 V(n004)
.step param R4 10k 40k 5k
.ac lin 10 100 1000
.meas TRAN gain MAX voutpkpk/vinpkpk
.meas vinpkpk PP V(Vin)
.step param R3 500 5000 500
.step dec param C2 0.5u 500u 5
.step dec param C4 0.5u 500u 10
