maneth-b03p/analog-guitar-effects-console/simulation-files/tremolo[1].asc

C1: cap; 2.2µ
C2: cap; 0.1µ
C3: cap; 3.3µ
D1: LED
Q1: npn; BC547B
R1: res; 1k
R2: res; 550k
R3: res; 1k
R4: res; 1k
R5: res; 1k
R6: res; 330
R7: res; 2k
U1: NE555
U2: PC817D
V1: voltage; 12
V2: voltage; PWL file=C:\Users\User\Downloads\guitar_signal.txt
Named nets: 0, Vcc, V_out1
.tran 10
.step param R7 2k 10k 2k
R2 is a potentiometer which controls the frequency of the tremolo effect
R7 is a potentiometer which controls the depth (Amplitude variation) of the tremolo effect
Should include the actual file path
